herry73/NeuroDrive/(commit log)

2026-06-11 Add config.json with ESP32 IP and port
2026-08-07 Add eeg_reader, signal_processor, command_mapper stubs + wire into main.py
2026-08-08 adding the full software stack including the documentations.
    [demo_session.csv]
